emoninet2/InteractiveGuitar/README.md

# InteractiveGuitar

Check documentation on https://github.com/emoninet2/InteractiveGuitar/wiki
