emoninet2/InteractiveGuitar/Board/README.md

# Interactive Guitar
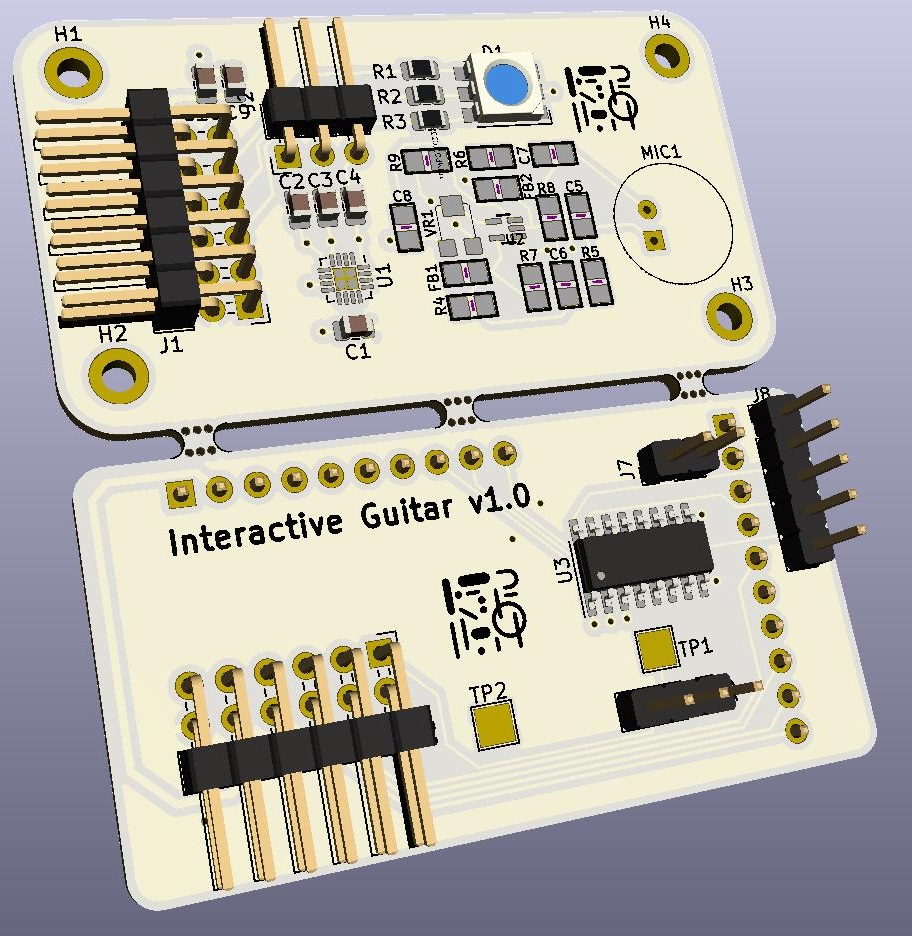
[picture p1: Board/Resources/InteractiveGuitar.jpg]
N|Solid
