emoninet2/InteractiveGuitar/documentation/bridgeConnection.png

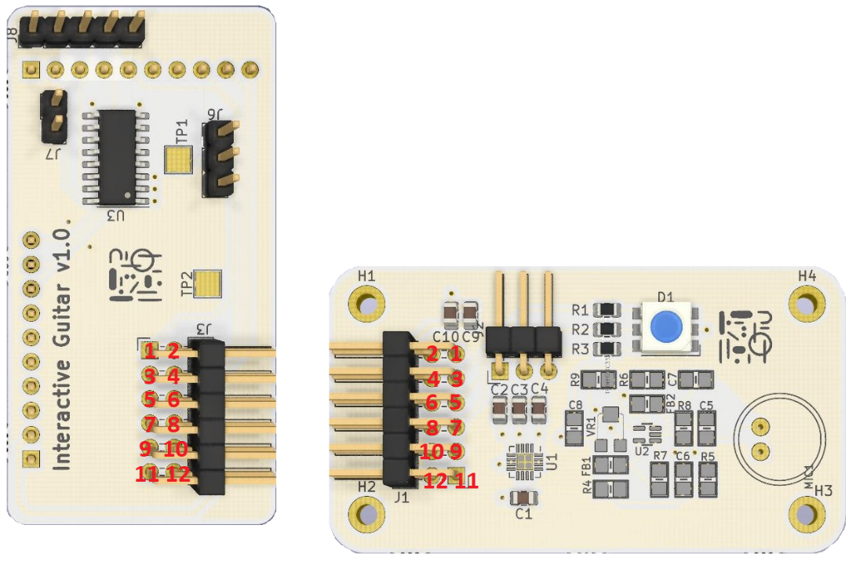
documentation/bridgeConnection.png
