emoninet2/InteractiveGuitar/documentation/casing3D.png

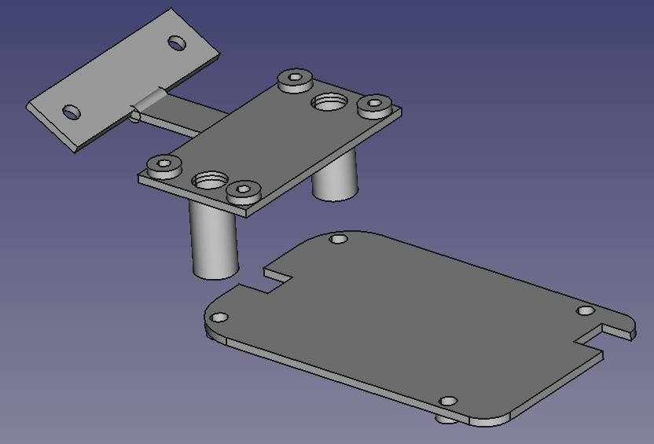
documentation/casing3D.png
