emoninet2/InteractiveGuitar/documentation/Connections.jpg

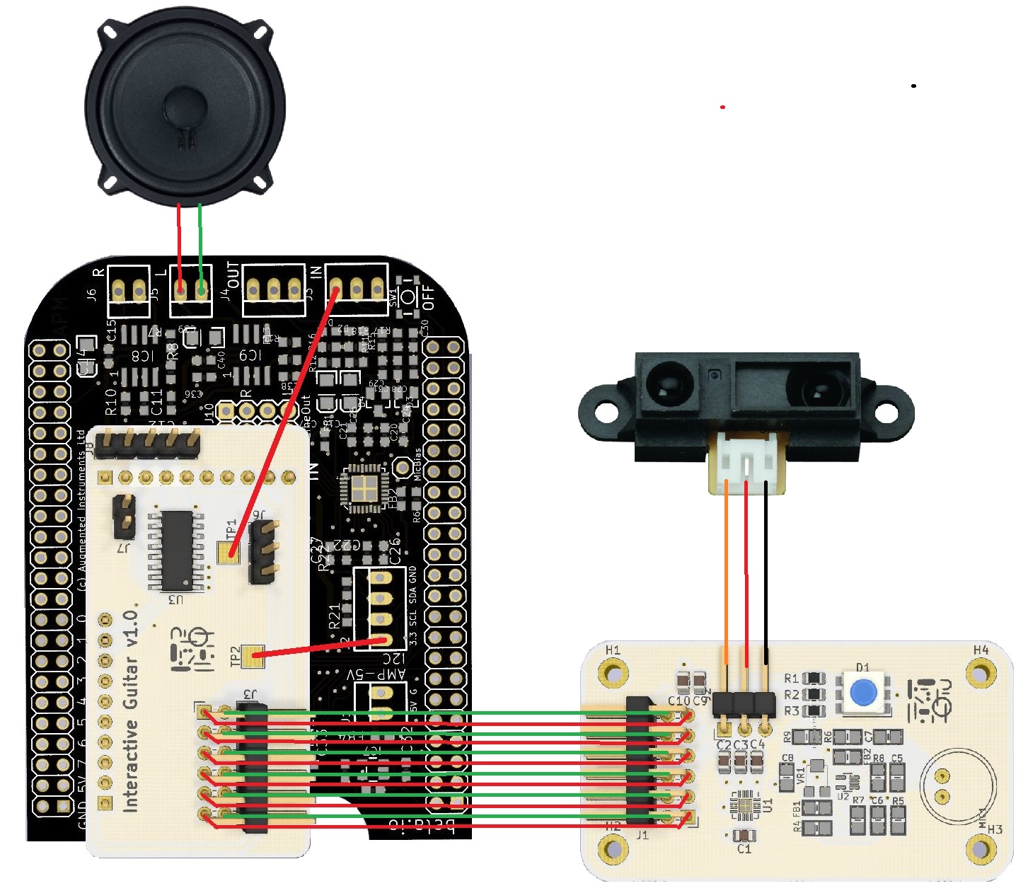
documentation/Connections.jpg
