emoninet2/InteractiveGuitar/documentation/Cura_01.PNG

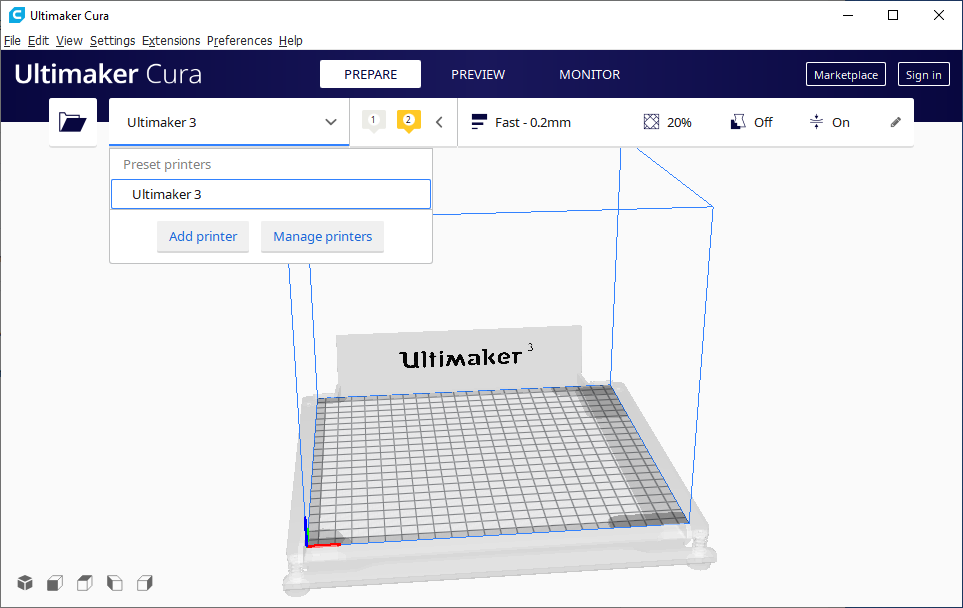
documentation/Cura_01.PNG
