emoninet2/InteractiveGuitar/documentation/Cura_02.PNG

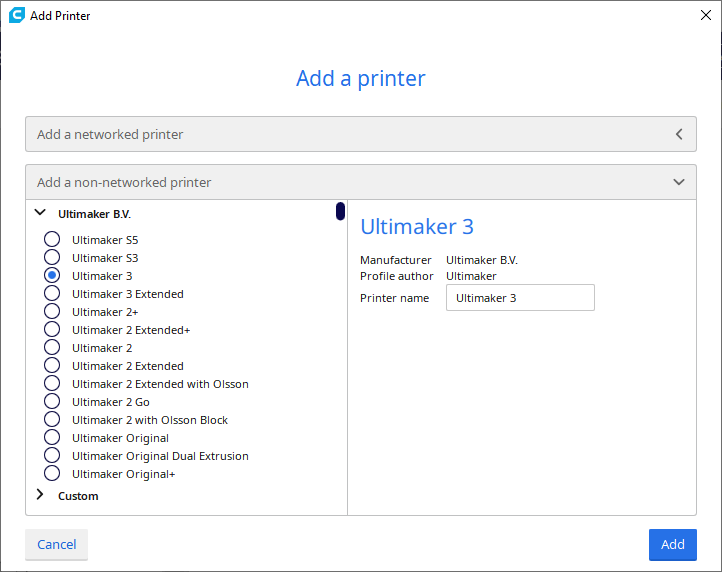
documentation/Cura_02.PNG
