emoninet2/InteractiveGuitar/documentation/Cura_03.PNG

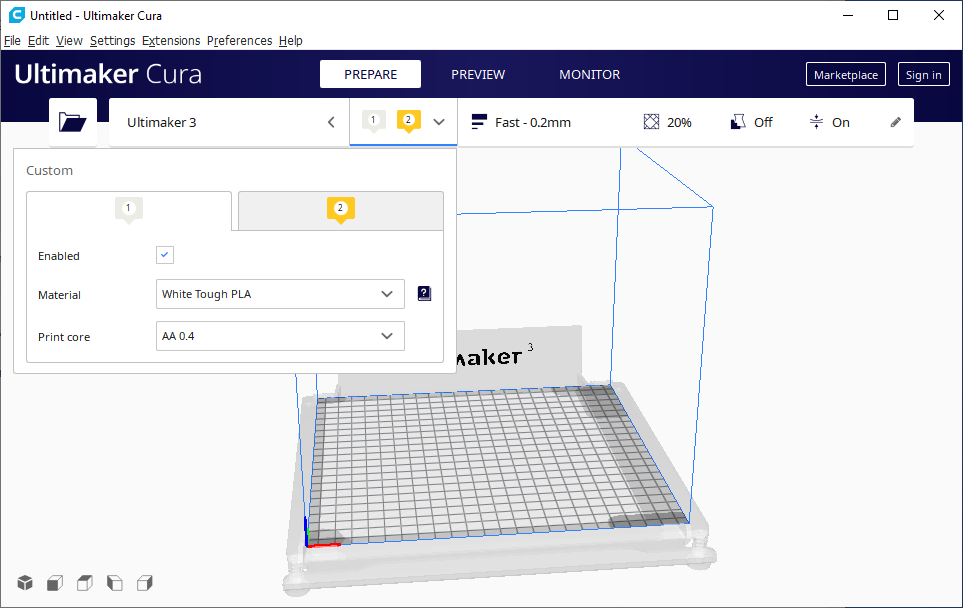
documentation/Cura_03.PNG
