emoninet2/InteractiveGuitar/documentation/Cura_04.PNG

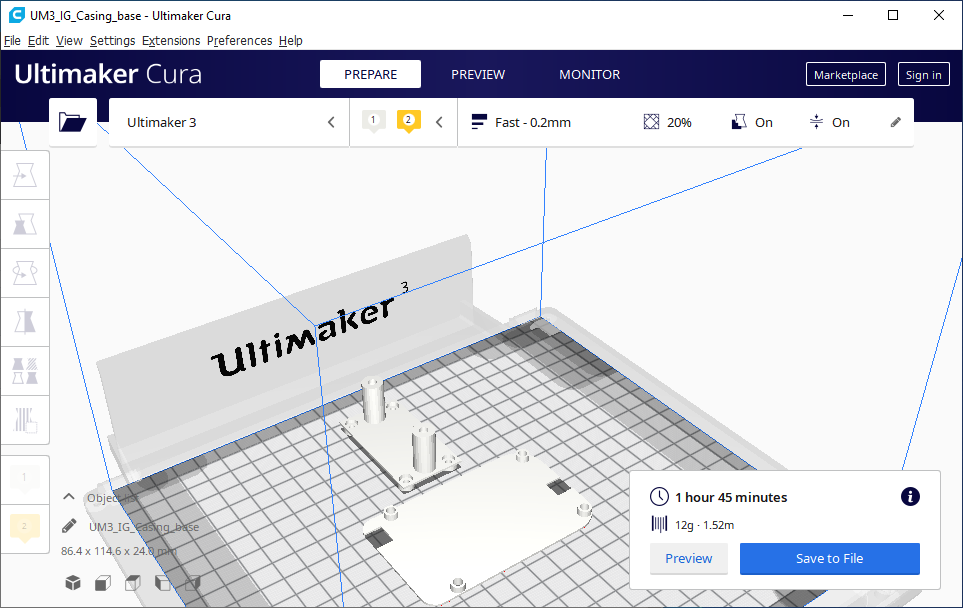
documentation/Cura_04.PNG
