emoninet2/InteractiveGuitar/documentation/IDE_01.PNG

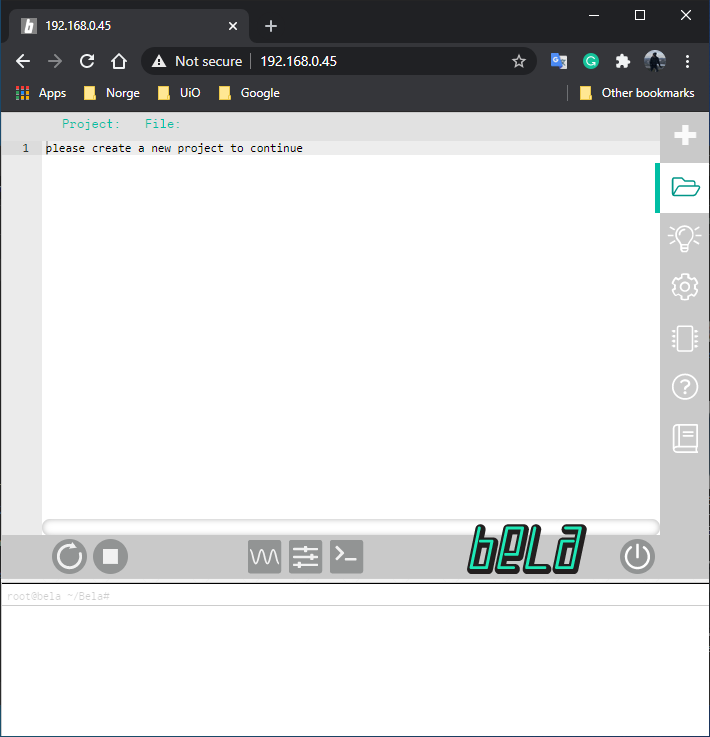
documentation/IDE_01.PNG
