emoninet2/InteractiveGuitar/documentation/IDE_02.PNG

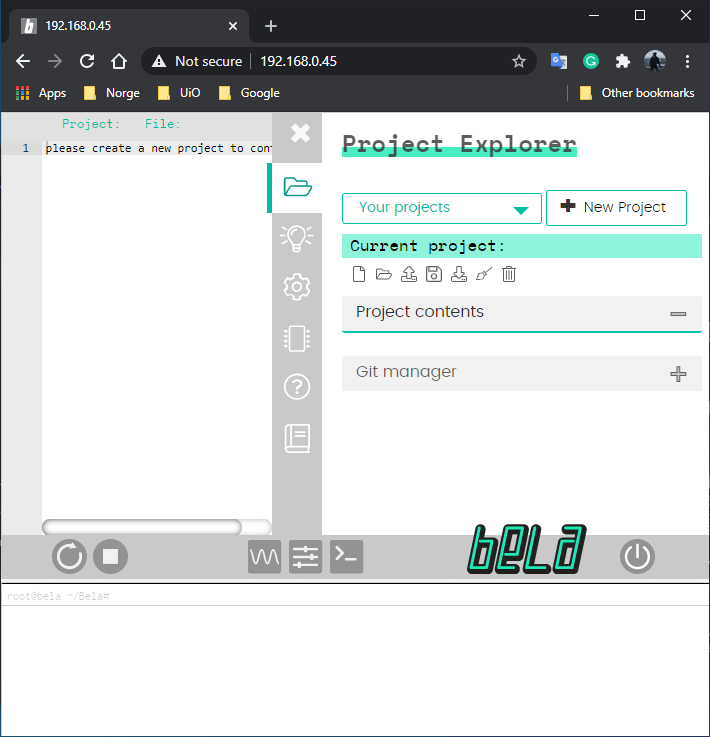
documentation/IDE_02.PNG
