emoninet2/InteractiveGuitar/documentation/IDE_03.PNG

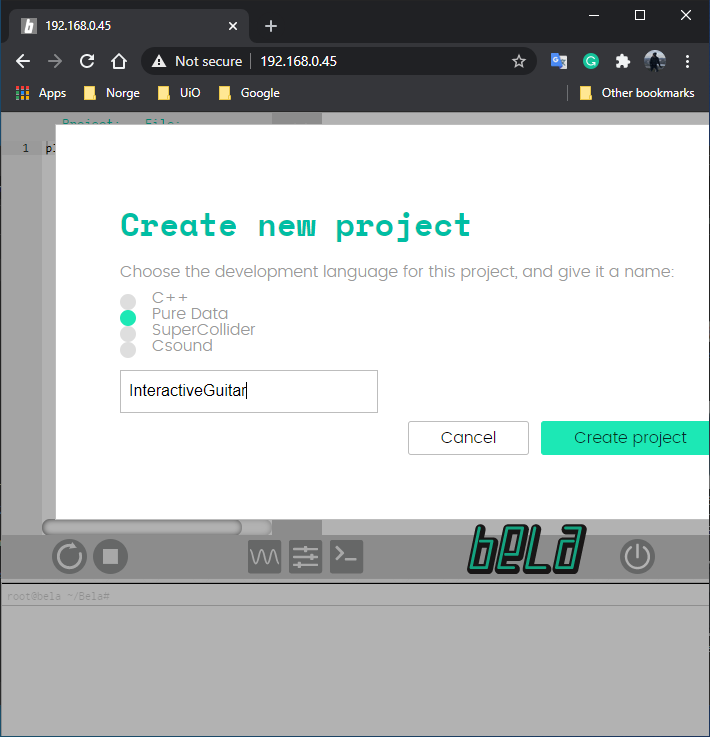
documentation/IDE_03.PNG
