emoninet2/InteractiveGuitar/documentation/IDE_04.PNG

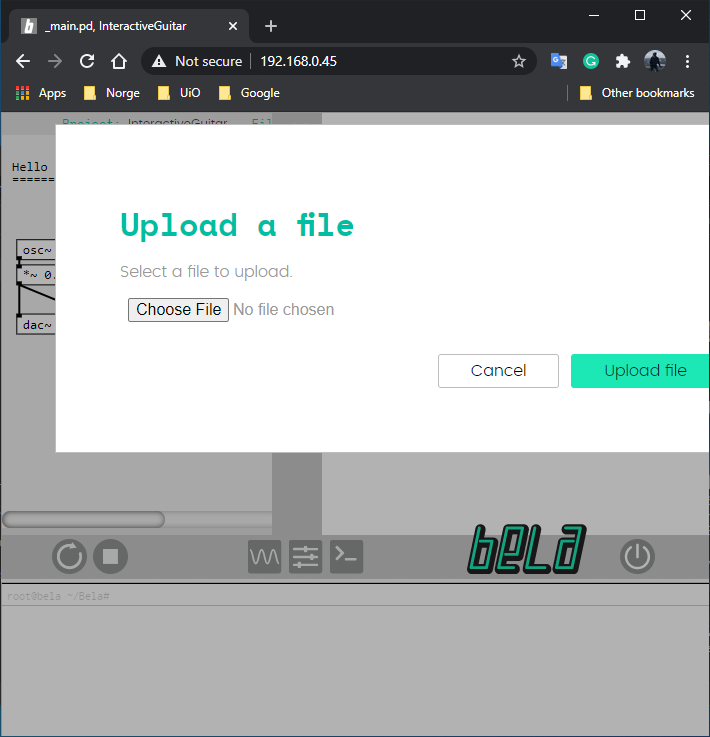
documentation/IDE_04.PNG
