emoninet2/InteractiveGuitar/documentation/IDE_05.PNG

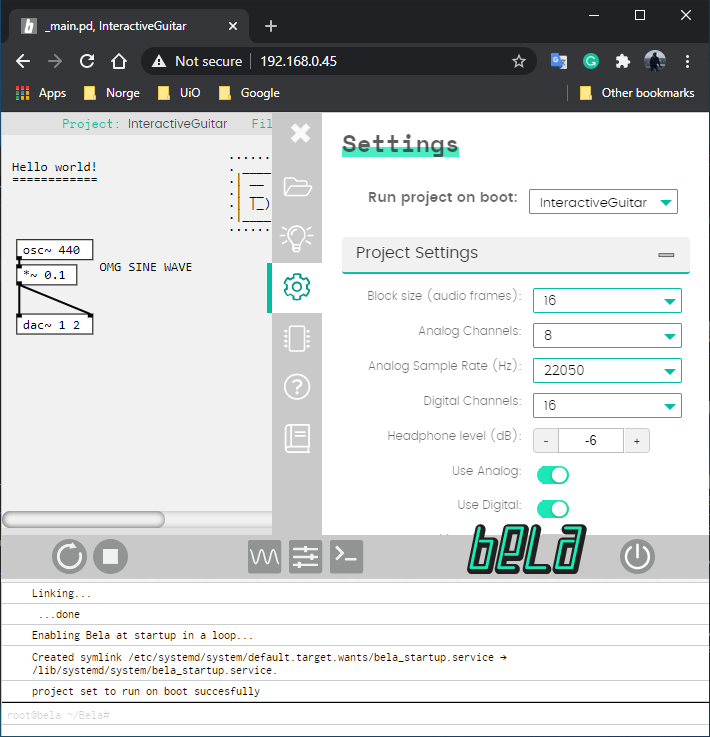
documentation/IDE_05.PNG
