emoninet2/InteractiveGuitar/documentation/kicadPlot.png

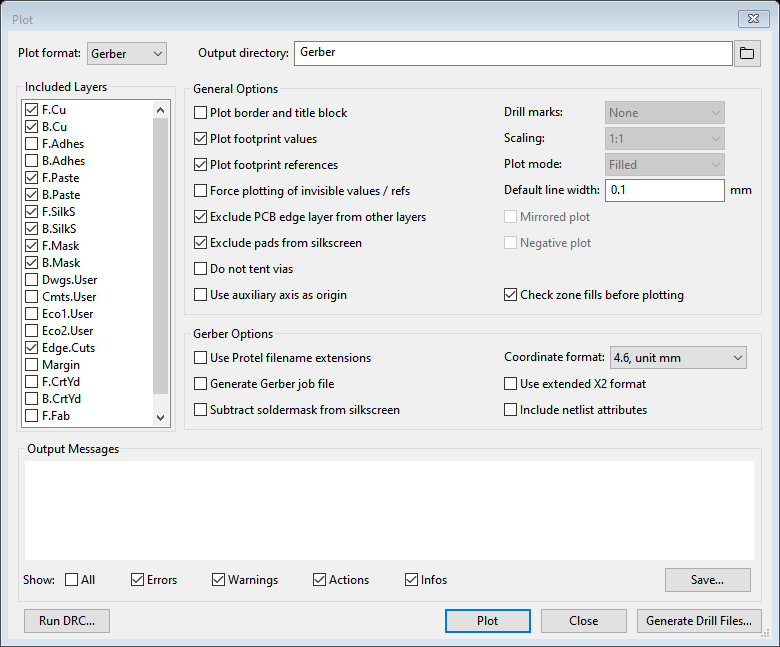
documentation/kicadPlot.png
