emoninet2/InteractiveGuitar/documentation/overallSystem.jpg

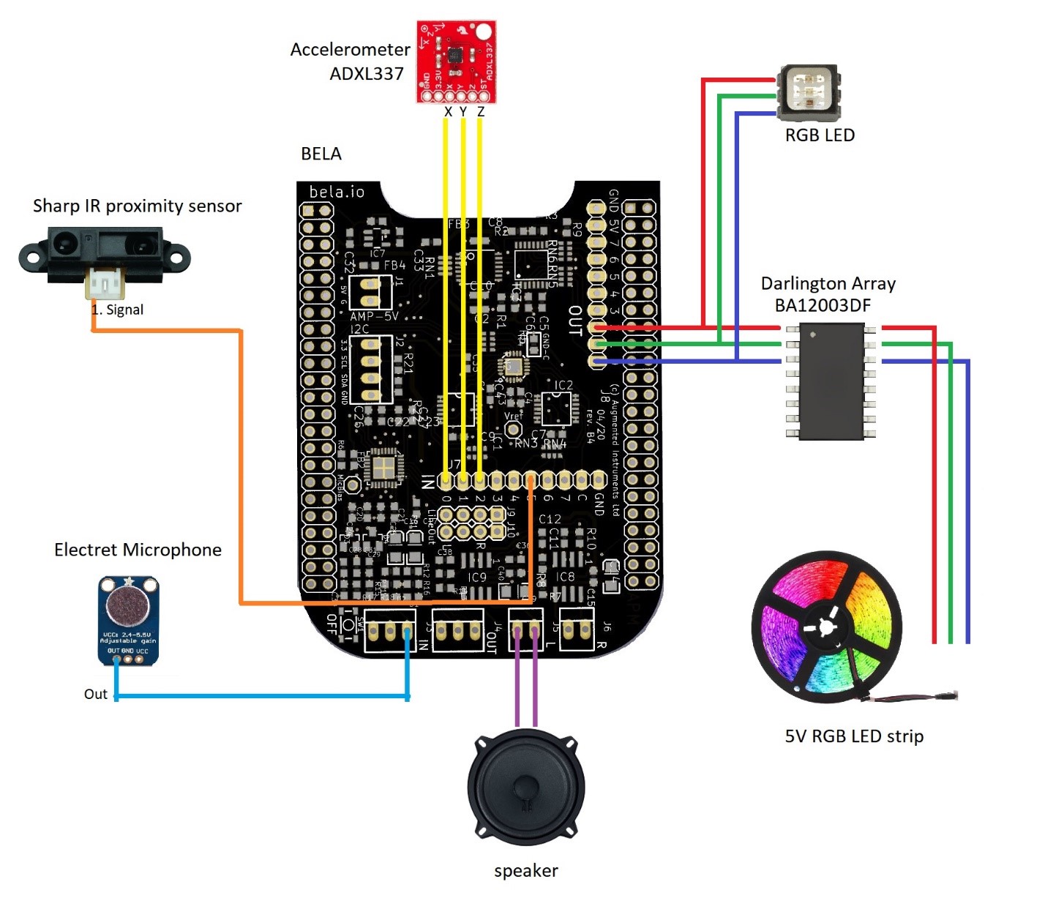
documentation/overallSystem.jpg
