emoninet2/InteractiveGuitar/documentation/pcbLayout.png

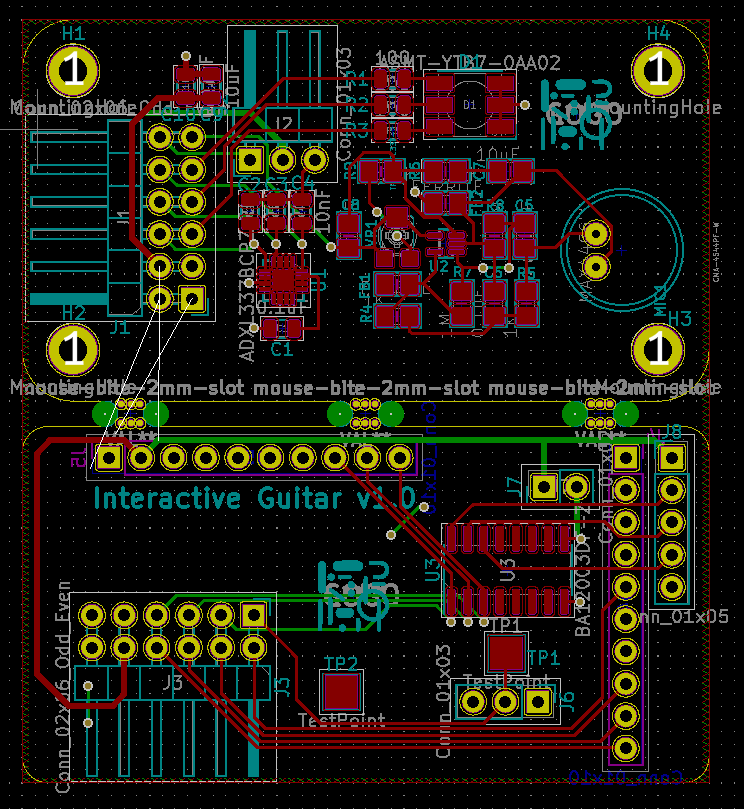
documentation/pcbLayout.png
