emoninet2/InteractiveGuitar/documentation/PCBOnHeadstock.JPG

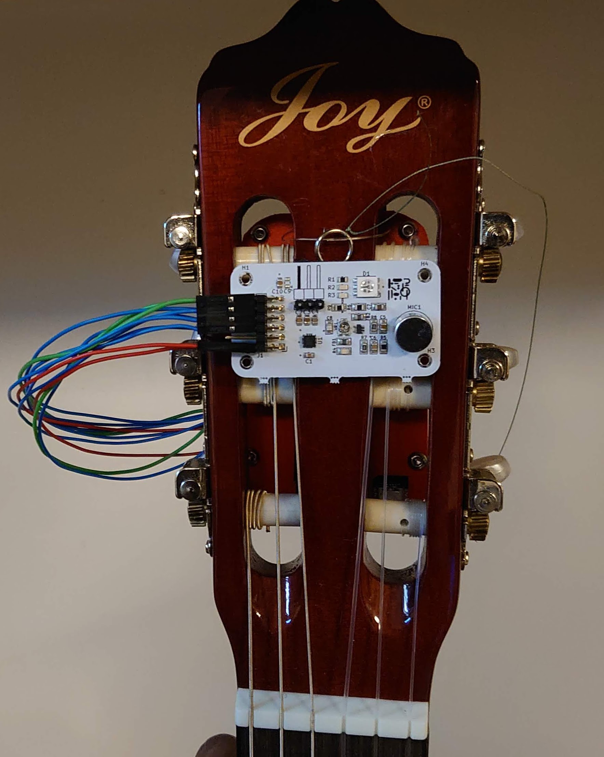
documentation/PCBOnHeadstock.JPG
