emoninet2/InteractiveGuitar/documentation/pcbRendered.jpg

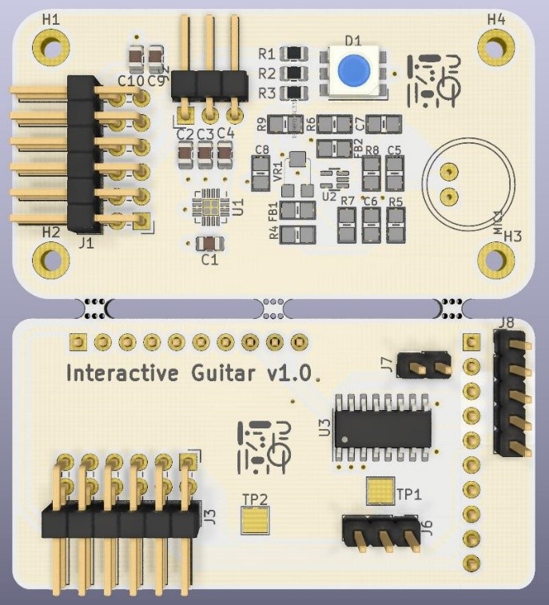
documentation/pcbRendered.jpg
