emoninet2/InteractiveGuitar/documentation/PinNumbering.jpg

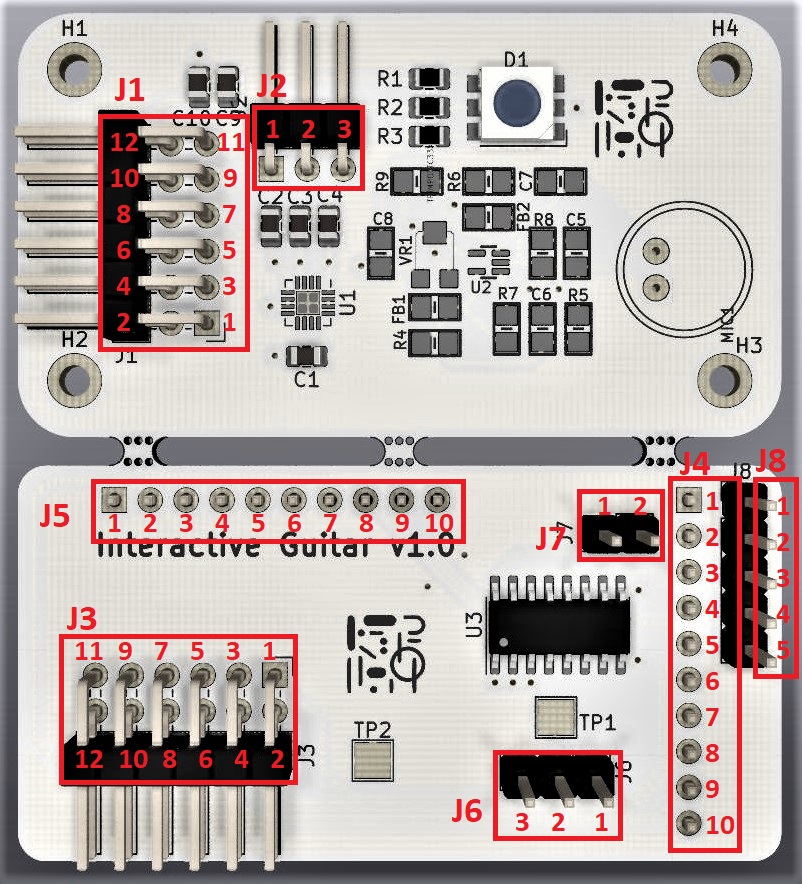
documentation/PinNumbering.jpg
