emoninet2/InteractiveGuitar/documentation/reflowOven.jpg

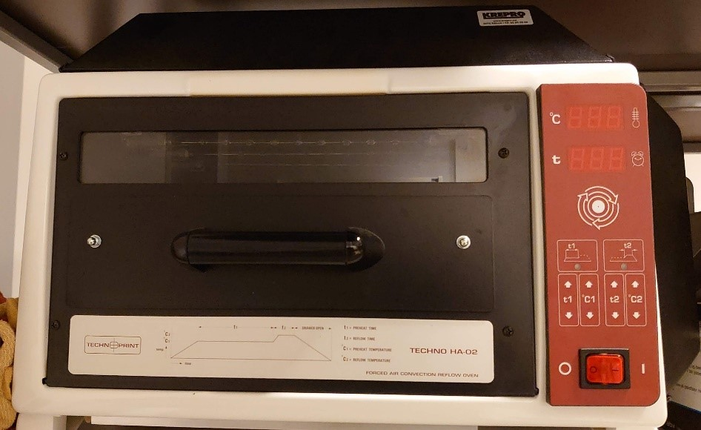
documentation/reflowOven.jpg
