emoninet2/InteractiveGuitar/documentation/reflowProfile.png

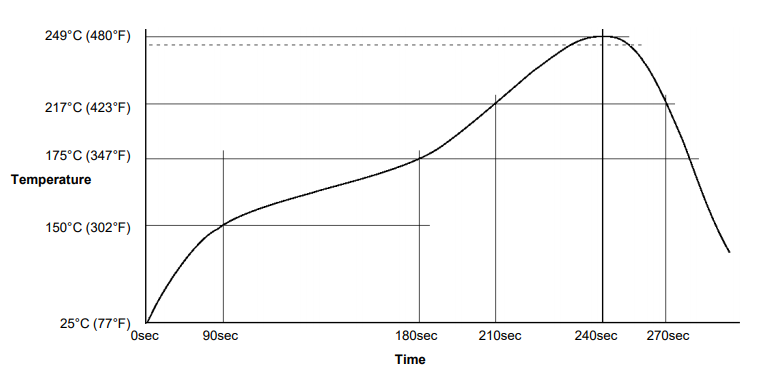
documentation/reflowProfile.png
