emoninet2/InteractiveGuitar/documentation/SegmentB_stacked.jpg

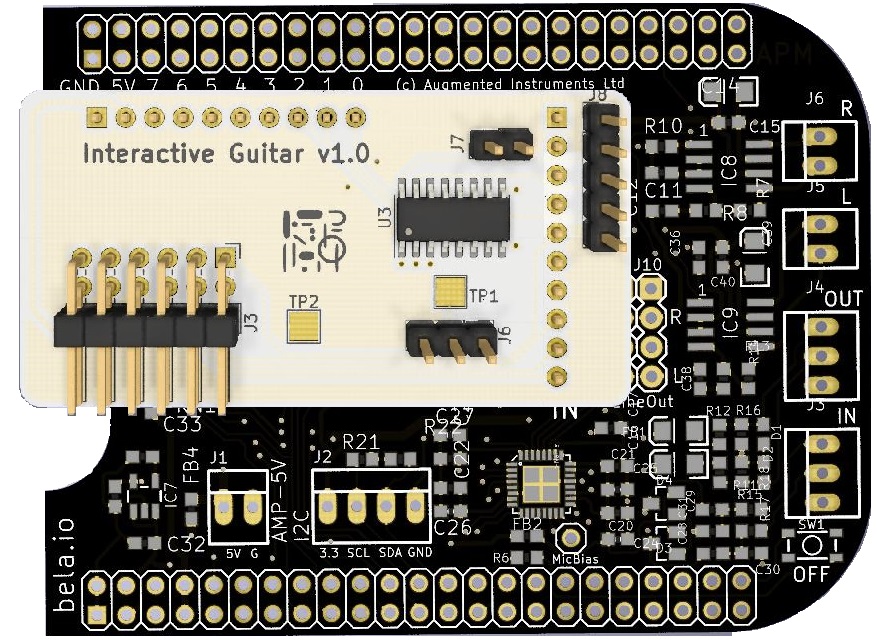
documentation/SegmentB_stacked.jpg
