emoninet2/InteractiveGuitar/documentation/stencil.jpg

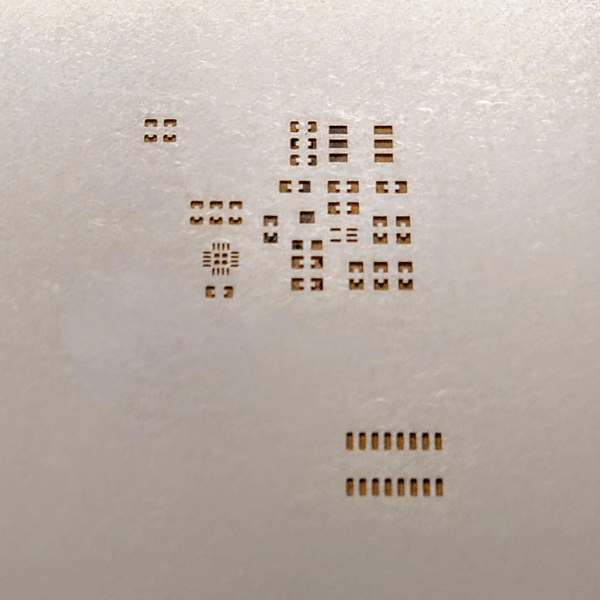
documentation/stencil.jpg
