emoninet2/InteractiveGuitar/documentation/jlcpcbOrder.png

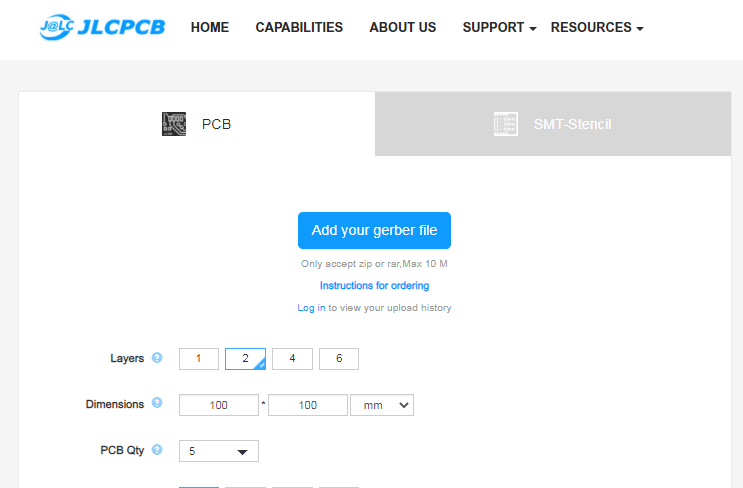
documentation/jlcpcbOrder.png
