emoninet2/InteractiveGuitar/Casing/IG_Casing_Top.FCStd

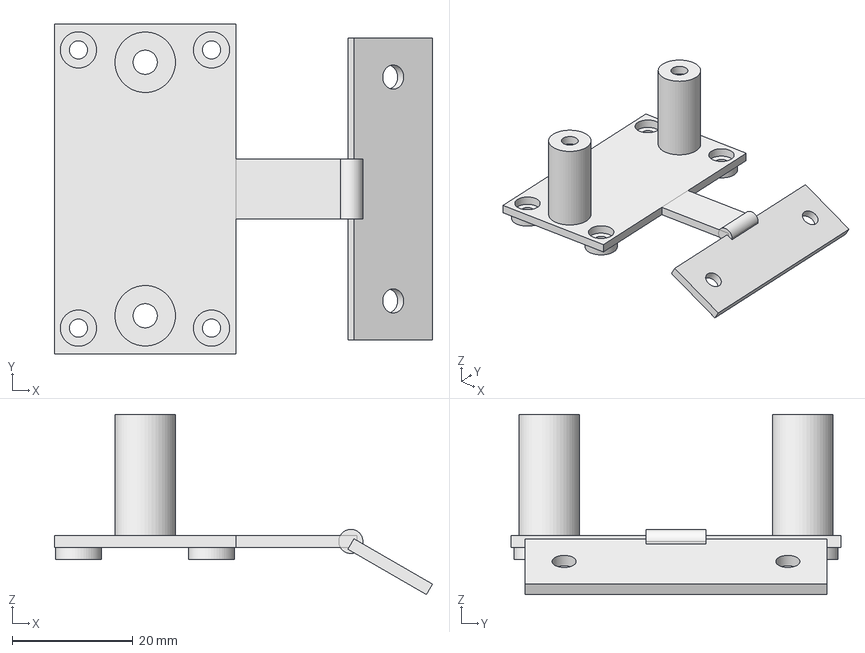
[picture p25: CAD file, 2020-09-28]
Casing/IG_Casing_Top.FCStd
62.5 x 54.6 x 29.8 mm
