emoninet2/InteractiveGuitar/Casing/IG_Casing.FCStd

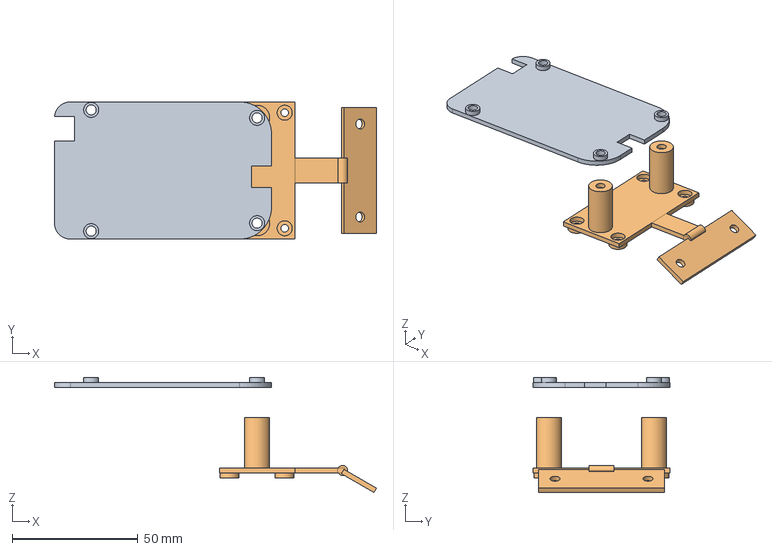
[picture p26: CAD file, 2020-09-28]
Casing/IG_Casing.FCStd
128.1 x 54.6 x 45.8 mm
BaseUnit
TopUnit
