emoninet2/InteractiveGuitar/Casing/IG_Casing_Base.FCStd

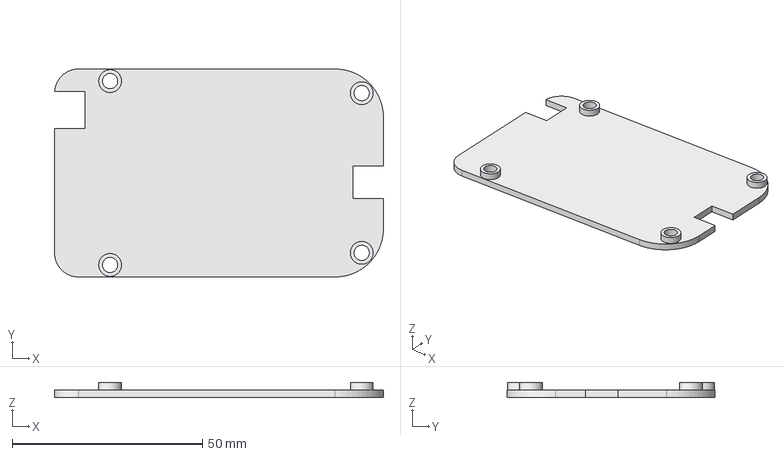
[picture p27: CAD file, 2020-09-28]
Casing/IG_Casing_Base.FCStd
86.4 x 54.6 x 4.00 mm
