emoninet2/InteractiveGuitar/(list of files, cad)

Other CAD files:
Casing/IG_Casing_Base.stl
Casing/IG_Casing_Top.stl
