emoninet2/InteractiveGuitar/documentation/pcbFabricated.jpg

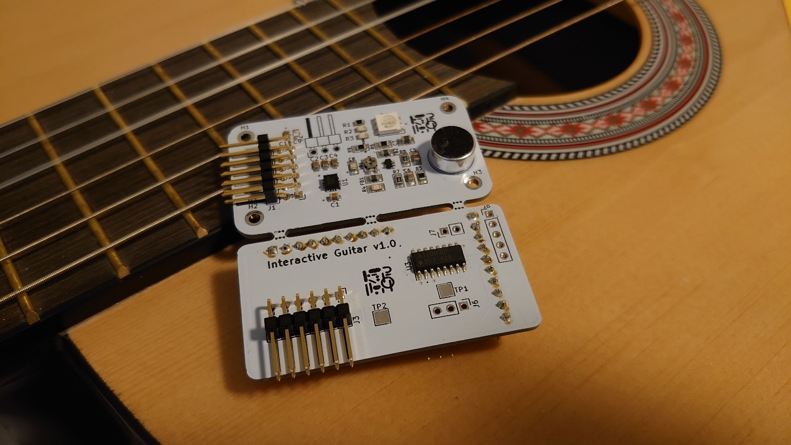
documentation/pcbFabricated.jpg
