emoninet2/InteractiveGuitar/Board/Schematic/InteractiveGuitar.pdf

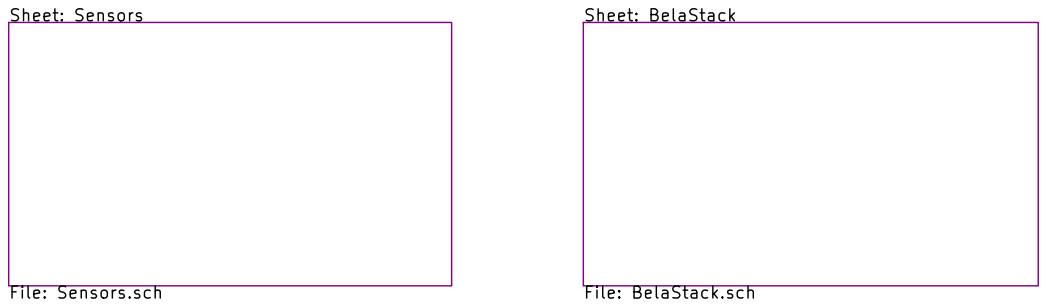
[picture p29: page 1]

Id: 1/3 Title: File: InteractiveGuitar.sch Sheet: /

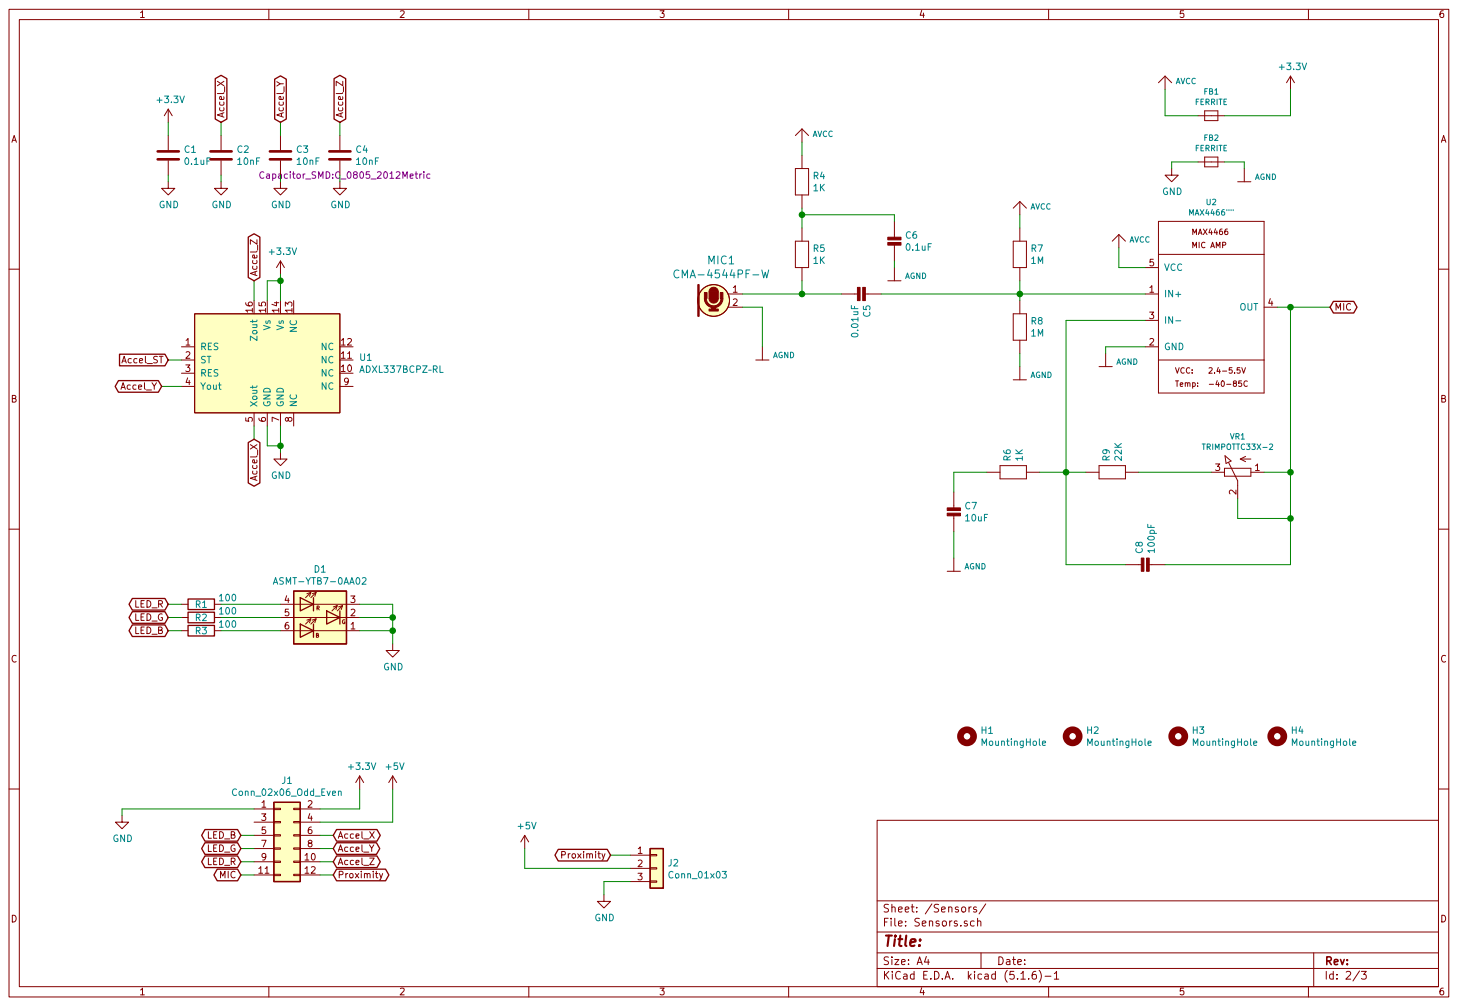
[picture p30: page 2]

J1 Conn_02x06_Odd_Even
Id: 2/3 Title: File: Sensors.sch Sheet: /Sensors/ 1

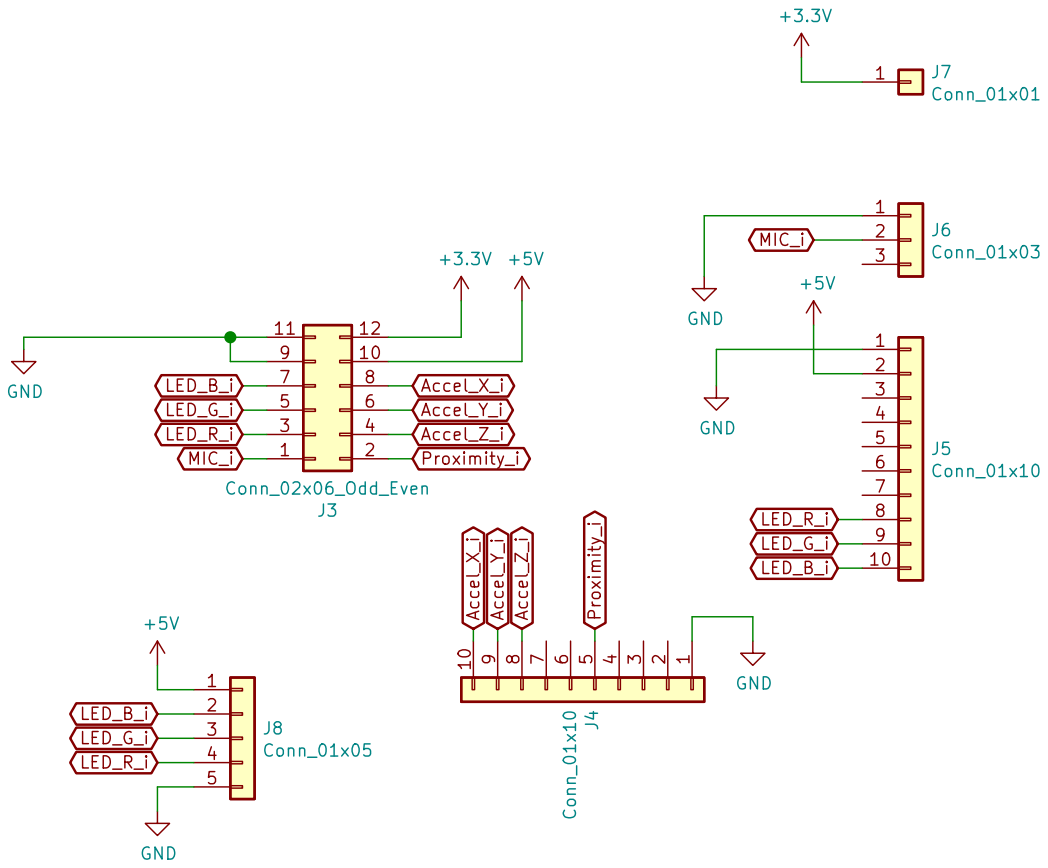
[picture p31: page 3]
