emoninet2/InteractiveGuitar/Board/InteractiveGuitar.kicad_pcb

## KiCad design Board/InteractiveGuitar.kicad_pcb (2020-07-22)

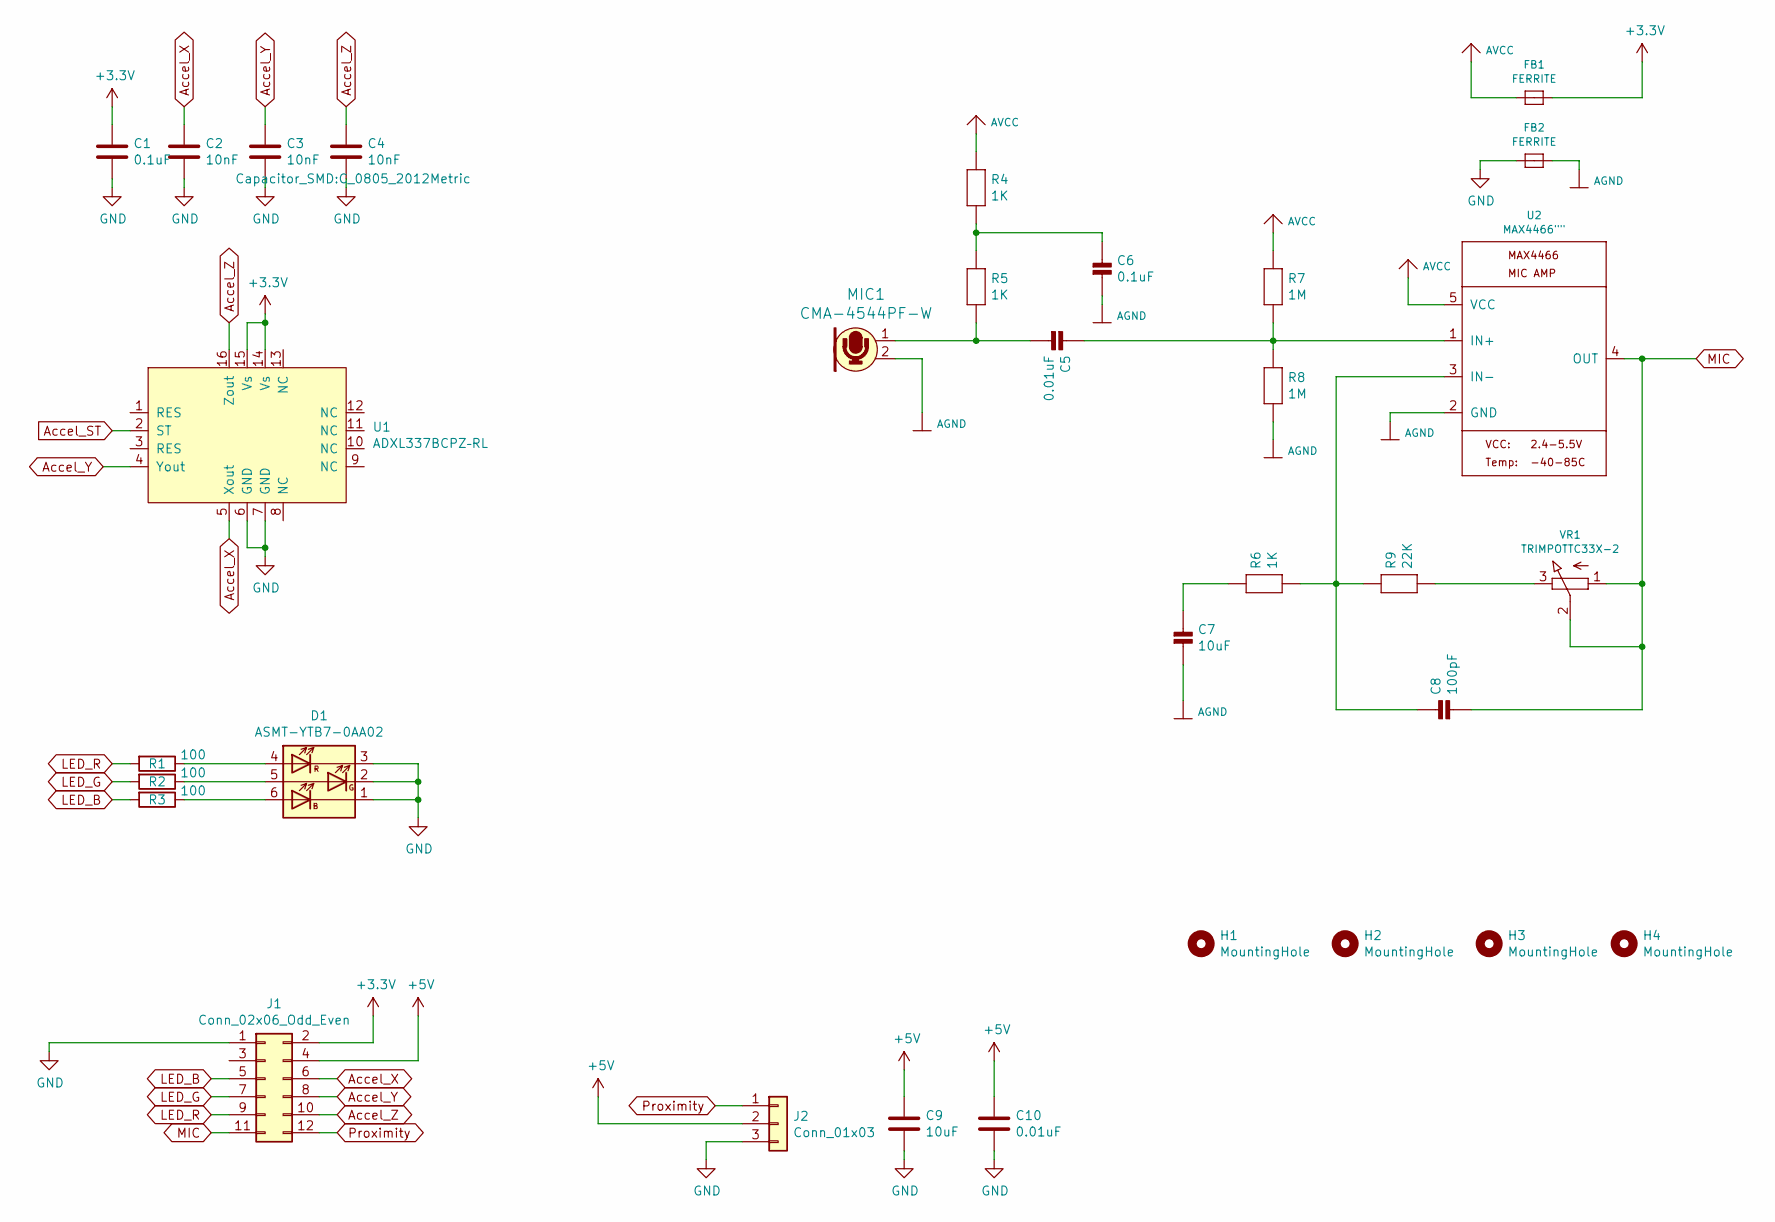
[picture p32: schematic Sensors.sch]

Parts:
C1: 0.1uF; C_0805_2012Metric
C2, C3, C4: 10nF; C_0805_2012Metric
C5: 0.01uF; 0805
C6: 0.1uF; 0805
C7: 10uF; 0805
C8: 100pF; 0805
C9: 10uF; C_0805_2012Metric
C10: 0.01uF; C_0805_2012Metric
D1: ASMT-YTB7-0AA02; LED_RGB_5050-6
FB1, FB2: FERRITE; 0805
H1, H2, H3, H4: MountingHole; MountingHole_2.2mm_M2_DIN965_Pad
J1: Conn_02x06_Odd_Even; PinHeader_2x06_P2.54mm_Horizontal
J2: Conn_01x03; PinHeader_1x03_P2.54mm_Horizontal
MIC1: CMA-4544PF-W; ELECTRET_9.7; MPN CMA-4544PF-W; Digi-Key_PN 102-1721-ND
R1, R2, R3: 100; R_0805_2012Metric
R4, R5, R6: 1K; 0805
R7, R8: 1M; 0805
R9: 22K; 0805
U1: ADXL337BCPZ–RL; LFCSP-16-1EP_3x3mm_P0.5mm_EP1.6x1.6mm
U2: MAX4466\"\"; SC70-5
VR1: TRIMPOTTC33X-2; TRIMPOT_BOURNS_TC33X-2

Connections:
+3V3: C1.1, FB1.2, J1.2, U1.14 (Vs), U1.15 (Vs); also elsewhere on the board
+5V: C9.1, C10.1, J1.4, J2.2; also elsewhere on the board
AGND: C6.2, C7.2, FB2.2, MIC1.2, R8.2, U2.2 (GND)
AVCC: FB1.1, R4.1, R7.1, U2.5 (VCC)
Accel_ST: U1.2 (ST)
Accel_X: C2.1, J1.6, U1.5 (Xout)
Accel_Y: C3.1, J1.8, U1.4 (Yout)
Accel_Z: C4.1, J1.10, U1.16 (Zout)
GND: C1.2, C2.2, C3.2, C4.2, C9.2, C10.2, D1.1 (KB), D1.2 (KG), D1.3 (KR), FB2.1, J1.1, J2.3, U1.6 (GND), U1.7 (GND); also elsewhere on the board
LED_B: J1.5, R3.2
LED_G: J1.7, R2.2
LED_R: J1.9, R1.2
MIC: C8.2, J1.11, U2.4 (OUT), VR1.1 (A), VR1.2 (S)
unnamed: C5.1, R7.2, R8.1, U2.1 (IN+)
unnamed: C5.2, MIC1.1, R5.2
unnamed: C6.1, R4.2, R5.1
unnamed: C7.1, R6.1
unnamed: C8.1, R6.2, R9.1, U2.3 (IN-)
unnamed: D1.4 (AR), R1.1
unnamed: D1.5 (AG), R2.1
unnamed: D1.6 (AB), R3.1
unnamed: R9.2, VR1.3 (E)
Proximity: J1.12, J2.1

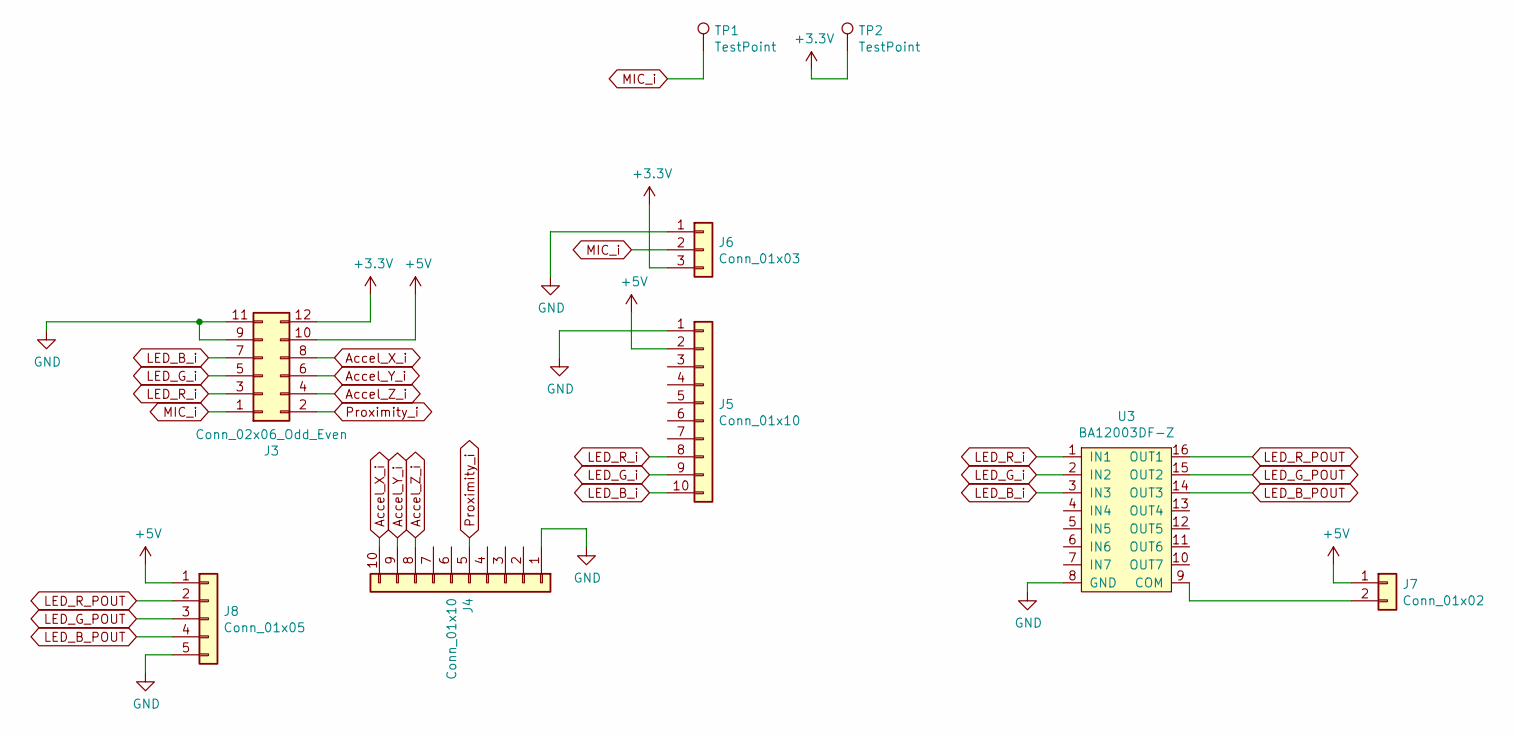
[picture p33: schematic BelaStack.sch]

Parts:
J3: Conn_02x06_Odd_Even; PinHeader_2x06_P2.54mm_Horizontal
J4, J5: Conn_01x10; PinHeader_1x10_P2.54mm_Vertical
J6: Conn_01x03; PinHeader_1x03_P2.54mm_Vertical
J7: Conn_01x02; PinHeader_1x02_P2.54mm_Vertical
J8: Conn_01x05; PinHeader_1x05_P2.54mm_Vertical
TP1, TP2: TestPoint; TestPoint_Pad_2.5x2.5mm
U3: BA12003DF-Z; SOIC-16_3.9x9.9mm_P1.27mm

Connections:
+3V3: J3.12, J6.3, TP2.1; also elsewhere on the board
+5V: J3.10, J5.2, J7.1, J8.1; also elsewhere on the board
Accel_X_i: J3.8, J4.10
Accel_Y_i: J3.6, J4.9
Accel_Z_i: J3.4, J4.8
GND: J3.9, J3.11, J4.1, J5.1, J6.1, J8.5, U3.8 (GND); also elsewhere on the board
LED_B_POUT: J8.4, U3.14 (OUT3)
LED_B_i: J3.7, J5.10, U3.3 (IN3)
LED_G_POUT: J8.3, U3.15 (OUT2)
LED_G_i: J3.5, J5.9, U3.2 (IN2)
LED_R_POUT: J8.2, U3.16 (OUT1)
LED_R_i: J3.3, J5.8, U3.1 (IN1)
MIC_i: J3.1, J6.2, TP1.1
unnamed: J7.2, U3.9 (COM)
Proximity_i: J3.2, J4.5

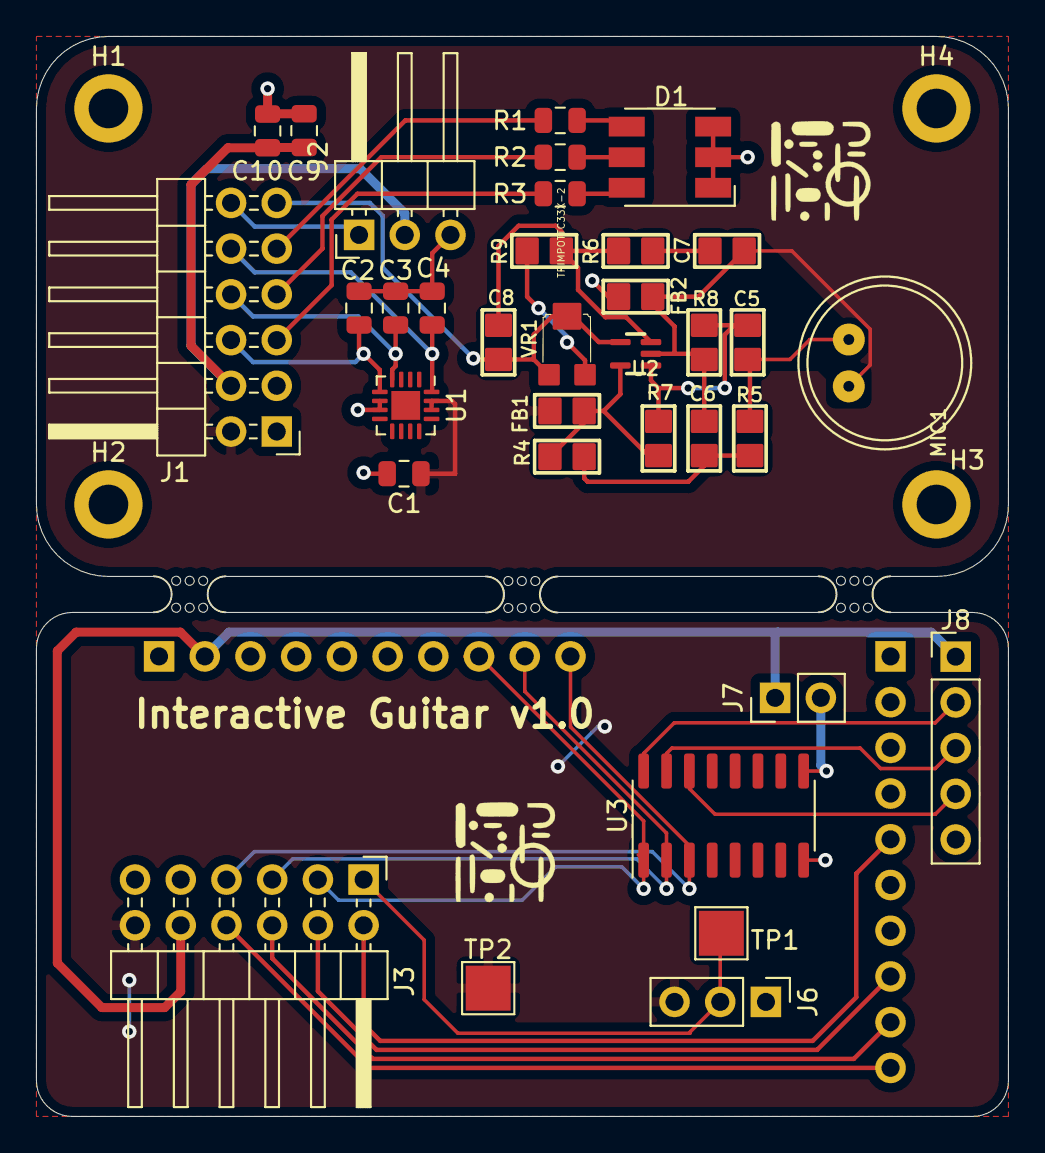
[picture p34: board InteractiveGuitar.kicad_pcb from above]

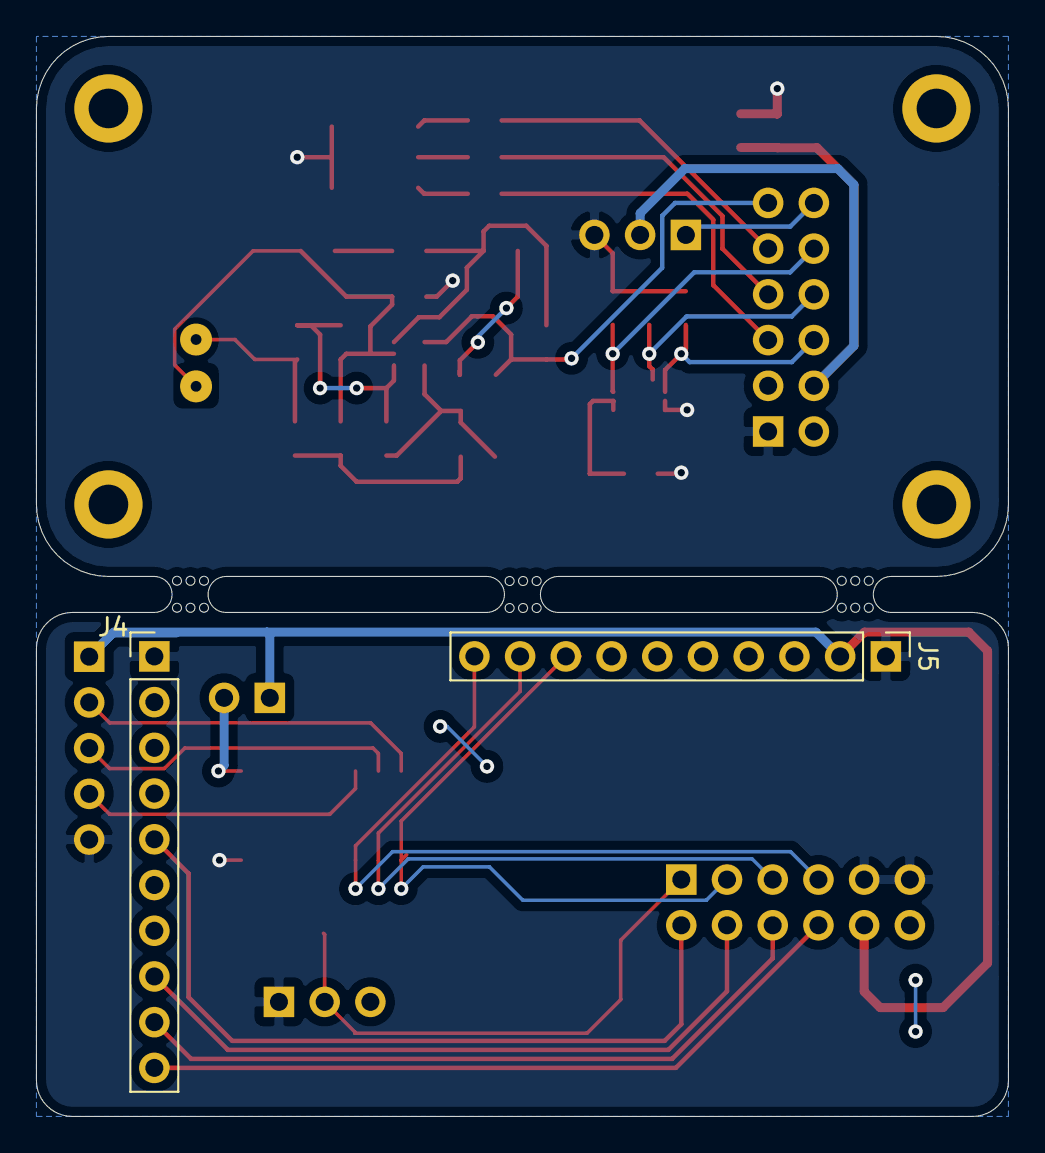
[picture p35: board InteractiveGuitar.kicad_pcb from below]

Board: 2 copper layers, 54.0 x 60.0 mm, 44 parts (2 on the bottom side), 34 nets.

Other parts of the board:
mouse-bite-2mm-slot, mouse-bite-2mm-slot#2, mouse-bite-2mm-slot#3: VAL**; mouse-bite-2mm-slot
