emoninet2/InteractiveGuitar/(commit log)

2020-07-08 added existing project files and folders
    [BelaStack.sch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]
2020-07-09 changed connection bits
    [InteractiveGuitar-B_Cu.gbr, InteractiveGuitar-B_Mask.gbr, InteractiveGuitar-B_Paste.gbr, InteractiveGuitar-B_SilkS.gbr, InteractiveGuitar-Edge_Cuts.gbr, InteractiveGuitar-F_Cu.gbr, InteractiveGuitar-F_Mask.gbr, InteractiveGuitar-F_Paste.gbr]
2020-07-22 fixed mic polarity
    [InteractiveGuitar.kicad_pcb, Sensors.sch]
2020-09-26 added case design and patch software
    [BelaStack.sch, IG_Casing.FCStd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]
2020-09-27 renamed image for bride connection. Added image for PCBOnHeadstock
2020-09-28 added separate stl file for the 3d casing. Added documentation images for cura ide
    [IG_Casing.FCStd, IG_Casing_Base.FCStd, IG_Casing_Base.stl, IG_Casing_Top.FCStd, IG_Casing_Top.stl]
2020-09-29 added documentation image for pcb pin numbering
